fer-clerkx/speeduino-expo/adapter/readme.md

64 pin for NA Toyota MR2 SW20 (1992)

# [For sale here](https://www.tindie.com/products/russian/ecu-64p-connector-bare-pcb-honda-miata-nanb1/)

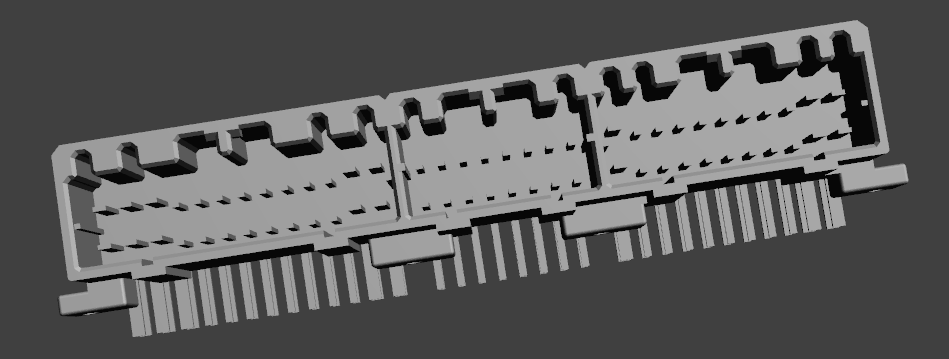
[picture p1: adapter/connector.png]
Connector


[Forum thread](https://rusefi.com/forum/viewtopic.php?f=4&t=507)
