fer-clerkx/speeduino-expo/adapter/Speeduino 1990 Rev2 3SGE ECU adapter 174518-7.kicad_pcb

## KiCad design adapter/Speeduino 1990 Rev2 3SGE ECU adapter 174518-7.kicad_pcb (2023-01-09)

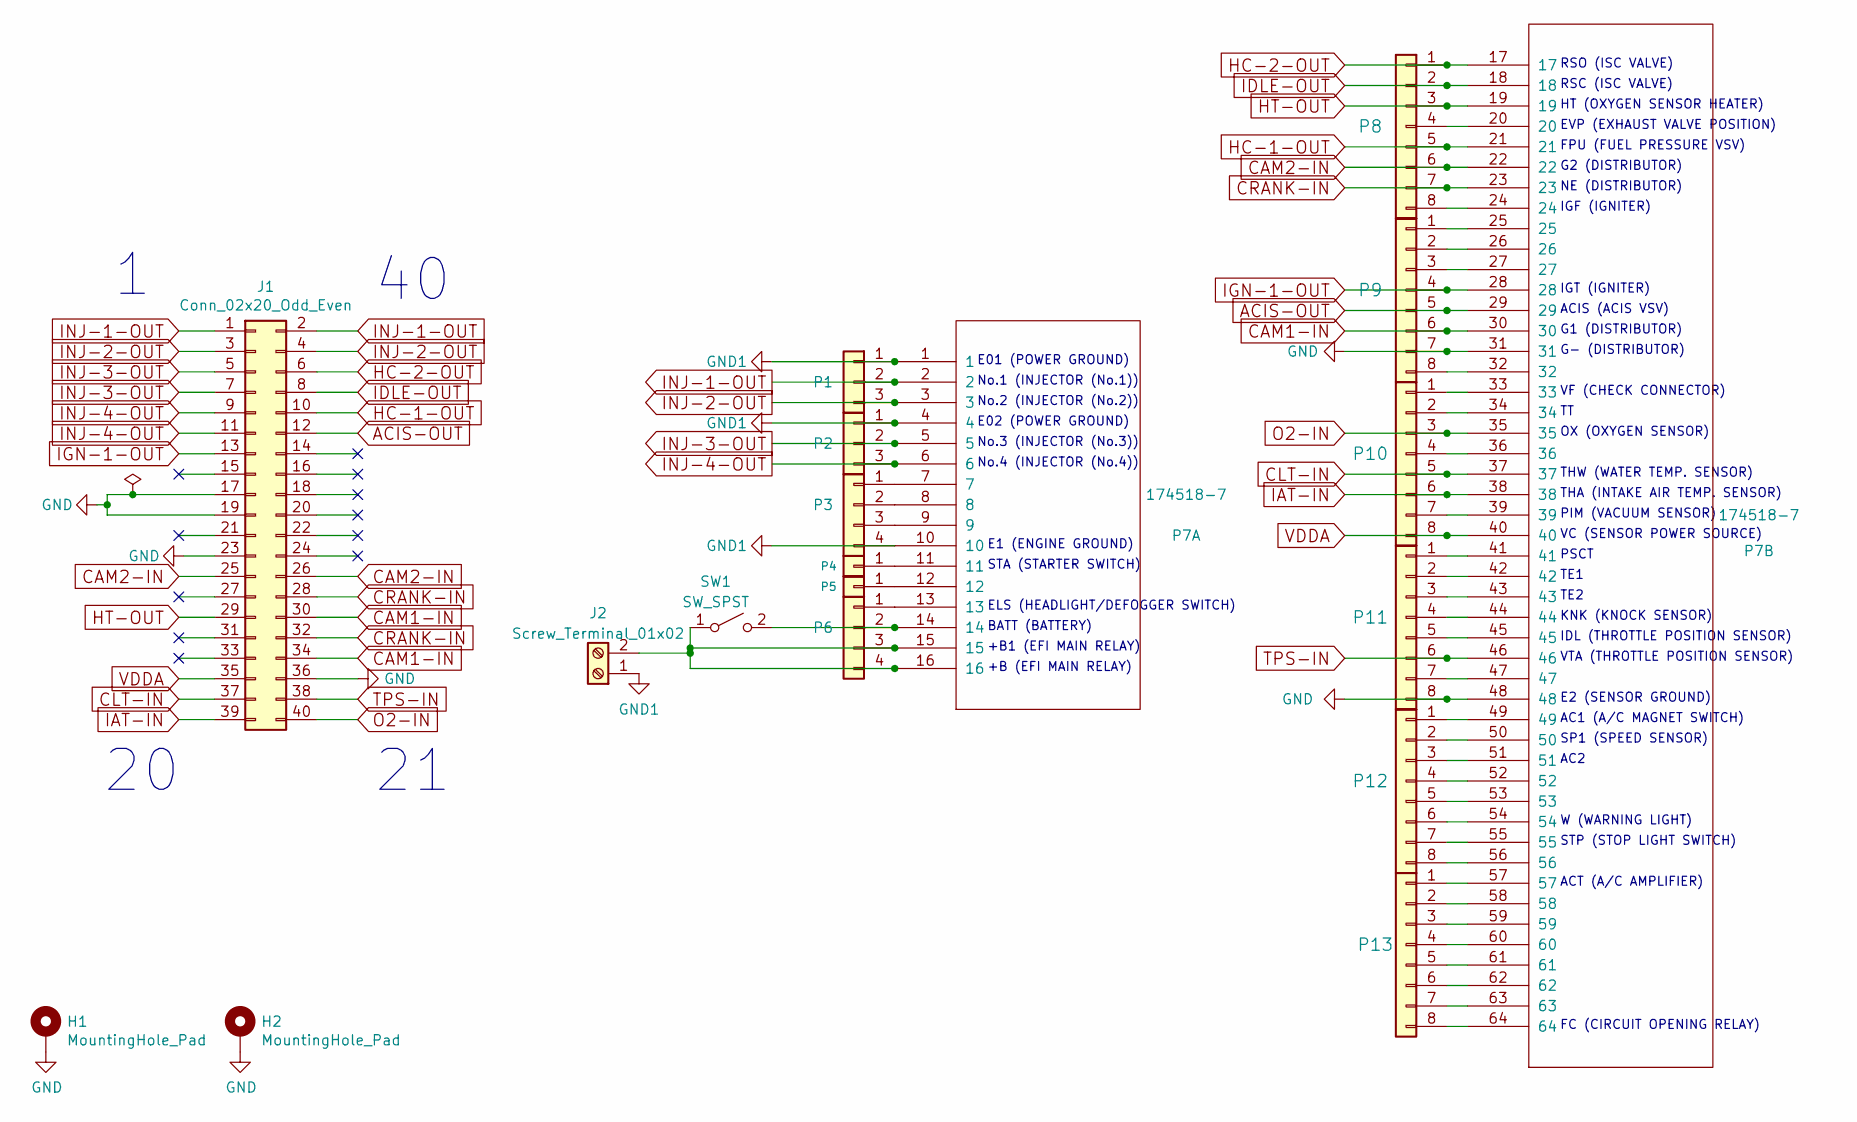
[picture p2: schematic Speeduino 1990 Rev2 3SGE ECU adapter 174518-7.kicad_sch, Speeduino 1990 R1 3S-GE ECU adapter by Jules van den Aker]

Parts:
H1, H2: MountingHole_Pad; MountingHole_3.2mm_M3_Pad_Via
J1: Conn_02x20_Odd_Even; IDC-Header_2x20_P2.54mm_Vertical
J2: Screw_Terminal_01x02; TerminalBlock_Phoenix_MKDS-1,5-2_1x02_P5.00mm_Horizontal
P1, P2: CONN_3; PinHeader_1x03_P2.54mm_Vertical
P3, P6: Conn_01x04_Male; PinHeader_2x02_P2.54mm_Vertical
P4, P5: CONN_1; PinHeader_1x01_P2.54mm_Vertical
P7: 174518-7
P8, P9, P10, P11, P12, P13: CONN_8; PinHeader_1x08_P2.54mm_Vertical
SW1: SW_SPST; SolderJumper-2_P1.3mm_Bridged_Pad1.0x1.5mm

Connections:
ACIS-OUT: J1.12, P7.29, P9.5
CAM1-IN: J1.30, J1.34, P7.30, P9.6
CAM2-IN: J1.25, J1.26, P7.22, P8.6
CLT-IN: J1.37, P7.37, P10.5
CRANK-IN: J1.28, J1.32, P7.23, P8.7
GND: H1.1, H2.1, J1.17, J1.19, J1.23, J1.36, P7.31, P7.48, P9.7, P11.8
GND1: J2.1, P1.1, P2.1, P3.4, P7.1, P7.4, P7.10
HC-1-OUT: J1.10, P7.21, P8.5
HC-2-OUT: J1.6, P7.17, P8.1
HT-OUT: J1.29, P7.19, P8.3
IAT-IN: J1.39, P7.38, P10.6
IDLE-OUT: J1.8, P7.18, P8.2
IGN-1-OUT: J1.13, P7.28, P9.4
INJ-1-OUT: J1.1, J1.2, P1.2, P7.2
INJ-2-OUT: J1.3, J1.4, P1.3, P7.3
INJ-3-OUT: J1.5, J1.7, P2.2, P7.5
INJ-4-OUT: J1.9, J1.11, P2.3, P7.6
unnamed: J2.2, P6.3, P6.4, P7.15, P7.16, SW1.1 (A)
unnamed: P3.1, P7.7
unnamed: P3.2, P7.8
unnamed: P3.3, P7.9
unnamed: P4.1, P7.11
unnamed: P5.1, P7.12
unnamed: P6.1, P7.13
unnamed: P6.2, P7.14, SW1.2 (B)
unnamed: P7.20, P8.4
unnamed: P7.24, P8.8
unnamed: P7.25, P9.1
unnamed: P7.26, P9.2
unnamed: P7.27, P9.3
unnamed: P7.32, P9.8
unnamed: P7.33, P10.1
unnamed: P7.34, P10.2
unnamed: P7.36, P10.4
unnamed: P7.39, P10.7
unnamed: P7.41, P11.1
unnamed: P7.42, P11.2
unnamed: P7.43, P11.3
unnamed: P7.44, P11.4
unnamed: P7.45, P11.5
unnamed: P7.47, P11.7
unnamed: P7.49, P12.1
unnamed: P7.50, P12.2
unnamed: P7.51, P12.3
unnamed: P7.52, P12.4
unnamed: P7.53, P12.5
unnamed: P7.54, P12.6
unnamed: P7.55, P12.7
unnamed: P7.56, P12.8
unnamed: P7.57, P13.1
unnamed: P7.58, P13.2
unnamed: P7.59, P13.3
unnamed: P7.60, P13.4
unnamed: P7.61, P13.5
unnamed: P7.62, P13.6
unnamed: P7.63, P13.7
unnamed: P7.64, P13.8
O2-IN: J1.40, P7.35, P10.3
TPS-IN: J1.38, P7.46, P11.6
VDDA: J1.35, P7.40, P10.8

Notes on the sheet:
IGT (IGNITER)
W (WARNING LIGHT)
E02 (POWER GROUND)
No.4 (INJECTOR (No.4))
G1 (DISTRIBUTOR)
No.2 (INJECTOR (No.2))
KNK (KNOCK SENSOR)
NE (DISTRIBUTOR)
STA (STARTER SWITCH)
FPU (FUEL PRESSURE VSV)
AC2
ACT (A/C AMPLIFIER)
+B1 (EFI MAIN RELAY)
RSO (ISC VALVE)
ELS (HEADLIGHT/DEFOGGER SWITCH)
G- (DISTRIBUTOR)
THA (INTAKE AIR TEMP. SENSOR)
No.3 (INJECTOR (No.3))
TE2
RSC (ISC VALVE)
VF (CHECK CONNECTOR)
HT (OXYGEN SENSOR HEATER)
TE1
THW (WATER TEMP. SENSOR)
+B (EFI MAIN RELAY)
E01 (POWER GROUND)
IGF (IGNITER)
OX (OXYGEN SENSOR)
G2 (DISTRIBUTOR)
No.1 (INJECTOR (No.1))
PSCT
FC (CIRCUIT OPENING RELAY)
VTA (THROTTLE POSITION SENSOR)
E2 (SENSOR GROUND)
VC (SENSOR POWER SOURCE)
SP1 (SPEED SENSOR)
ACIS (ACIS VSV)
AC1 (A/C MAGNET SWITCH)
IDL (THROTTLE POSITION SENSOR)
STP (STOP LIGHT SWITCH)
E1 (ENGINE GROUND)
PIM (VACUUM SENSOR)
EVP (EXHAUST VALVE POSITION)
BATT (BATTERY)

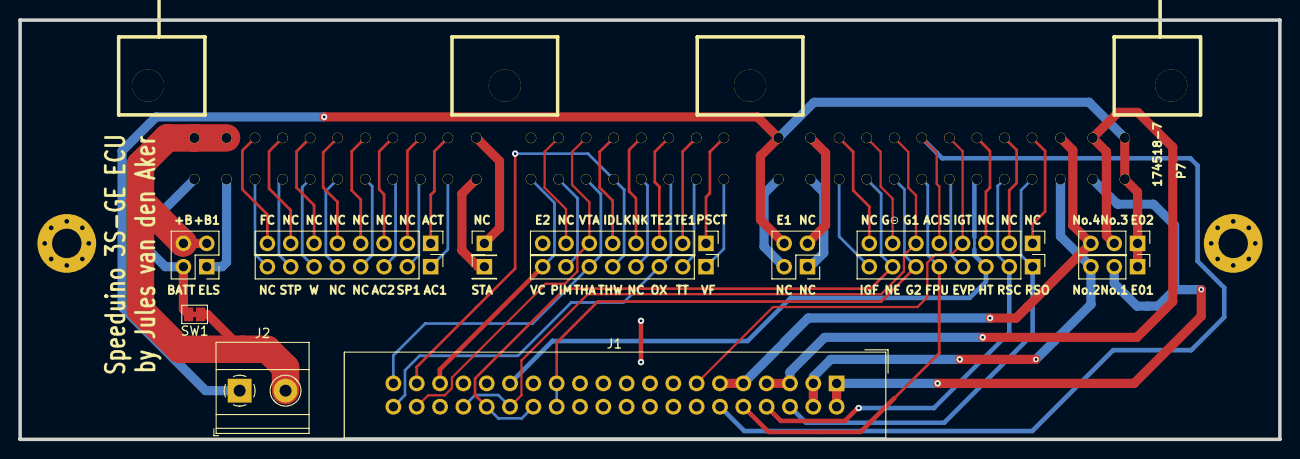
[picture p3: board Speeduino 1990 Rev2 3SGE ECU adapter 174518-7.kicad_pcb from above]

Board: 2 copper layers, 137.2 x 45.6 mm, 18 parts (0 on the bottom side), 60 nets.
