fer-clerkx/speeduino-expo/ECU_Board/perfectV2.1v0.kicad_pcb

## KiCad design ECU_Board/perfectV2.1v0.kicad_pcb (2023-01-07)

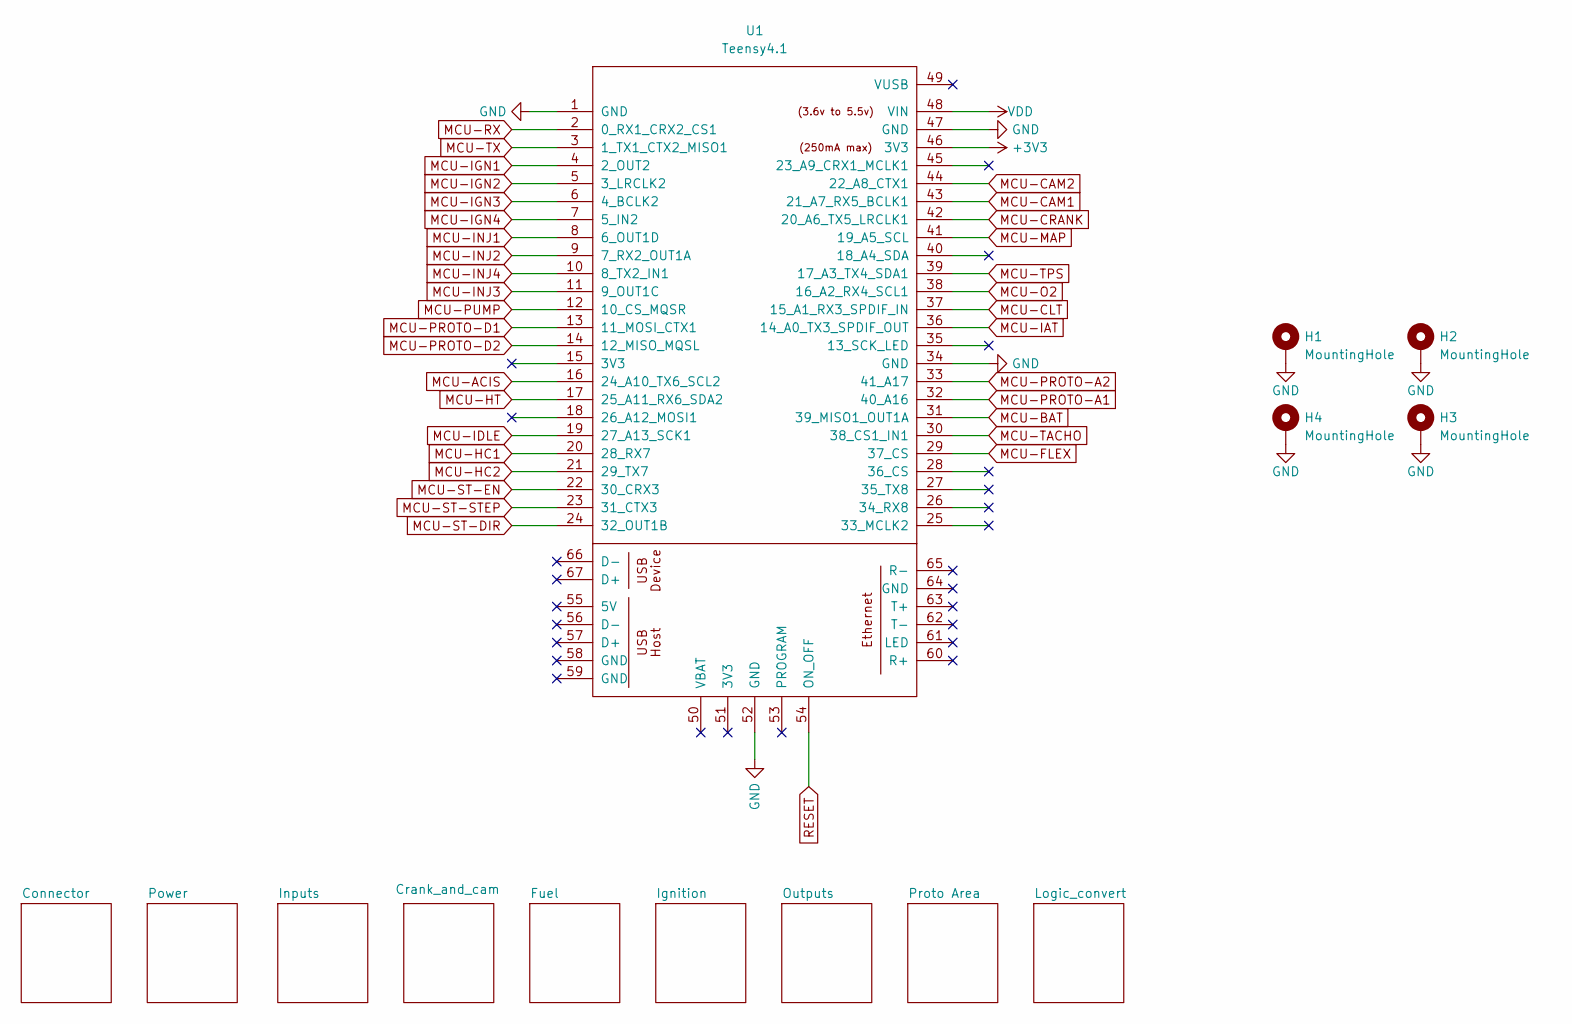
[picture p4: schematic perfectV2.1v0.kicad_sch, Speeduino board for Teensy 4.1]

Parts:
H1, H2, H3, H4: MountingHole; MountingHole_4.3mm_M4_Pad
U1: Teensy4.1; Teensy41

Connections:
+3V3: U1.46 (3V3); also elsewhere on the board
GND: H1.1, H2.1, H3.1, H4.1, U1.1 (GND), U1.34 (GND), U1.47 (GND), U1.52 (GND); also elsewhere on the board
MCU-ACIS: U1.16 (24_A10_TX6_SCL2); also elsewhere on the board
MCU-BAT: U1.31 (39_MISO1_OUT1A); also elsewhere on the board
MCU-CAM1: U1.43 (21_A7_RX5_BCLK1); also elsewhere on the board
MCU-CAM2: U1.44 (22_A8_CTX1); also elsewhere on the board
MCU-CLT: U1.37 (15_A1_RX3_SPDIF_IN); also elsewhere on the board
MCU-CRANK: U1.42 (20_A6_TX5_LRCLK1); also elsewhere on the board
MCU-FLEX: U1.29 (37_CS); also elsewhere on the board
MCU-HC1: U1.20 (28_RX7); also elsewhere on the board
MCU-HC2: U1.21 (29_TX7); also elsewhere on the board
MCU-HT: U1.17 (25_A11_RX6_SDA2); also elsewhere on the board
MCU-IAT: U1.36 (14_A0_TX3_SPDIF_OUT); also elsewhere on the board
MCU-IDLE: U1.19 (27_A13_SCK1); also elsewhere on the board
MCU-IGN1: U1.4 (2_OUT2); also elsewhere on the board
MCU-IGN2: U1.5 (3_LRCLK2); also elsewhere on the board
MCU-IGN3: U1.6 (4_BCLK2); also elsewhere on the board
MCU-IGN4: U1.7 (5_IN2); also elsewhere on the board
MCU-INJ1: U1.8 (6_OUT1D); also elsewhere on the board
MCU-INJ2: U1.9 (7_RX2_OUT1A); also elsewhere on the board
MCU-INJ3: U1.11 (9_OUT1C); also elsewhere on the board
MCU-INJ4: U1.10 (8_TX2_IN1); also elsewhere on the board
MCU-MAP: U1.41 (19_A5_SCL); also elsewhere on the board
MCU-O2: U1.38 (16_A2_RX4_SCL1); also elsewhere on the board
MCU-PROTO-A1: U1.32 (40_A16); also elsewhere on the board
MCU-PROTO-A2: U1.33 (41_A17); also elsewhere on the board
MCU-PROTO-D1: U1.13 (11_MOSI_CTX1); also elsewhere on the board
MCU-PROTO-D2: U1.14 (12_MISO_MQSL); also elsewhere on the board
MCU-PUMP: U1.12 (10_CS_MQSR); also elsewhere on the board
MCU-RX: U1.2 (0_RX1_CRX2_CS1); also elsewhere on the board
MCU-ST-DIR: U1.24 (32_OUT1B); also elsewhere on the board
MCU-ST-EN: U1.22 (30_CRX3); also elsewhere on the board
MCU-ST-STEP: U1.23 (31_CTX3); also elsewhere on the board
MCU-TACHO: U1.30 (38_CS1_IN1); also elsewhere on the board
MCU-TPS: U1.39 (17_A3_TX4_SDA1); also elsewhere on the board
MCU-TX: U1.3 (1_TX1_CTX2_MISO1); also elsewhere on the board
RESET: U1.54 (ON_OFF); also elsewhere on the board
VDD: U1.48 (VIN); also elsewhere on the board

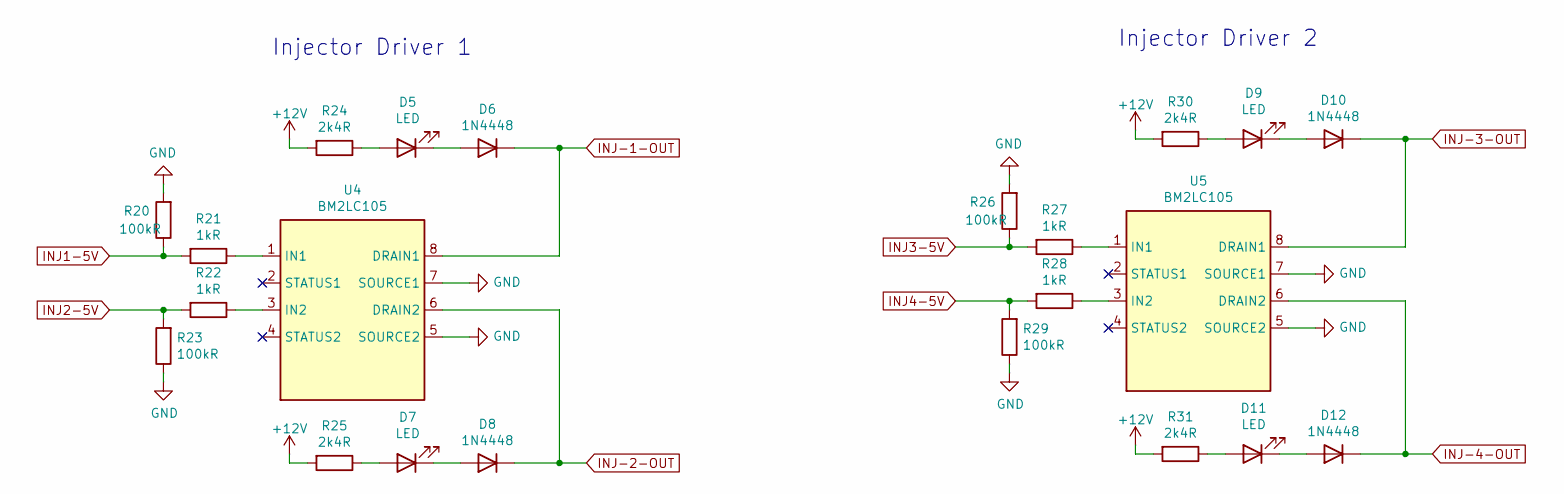
[picture p5: schematic Fuel.kicad_sch, Speeduino board for Teensy 4.1]

Parts:
D5, D7, D9, D11: LED; LED_0805_2012Metric; Manufacturer_Part_Number MP008293; Digikey Part Number 3796325
D6, D8, D10, D12: 1N4448; D_SOD-123; Manufacturer_Part_Number 1N4448W-7-F; Digikey Part Number 1843738
R20, R23, R26, R29: 100kR; R_0402_1005Metric; Manufacturer_Part_Number WF04P1003FTL; Digikey Part Number 2502803
R21, R22, R27, R28: 1kR; R_0402_1005Metric; Manufacturer_Part_Number WF04P1001FTL; Digikey Part Number 2502798
R24, R25, R30, R31: 2k4R; R_0805_2012Metric; Manufacturer_Part_Number MCWR08X2401FTL; Digikey Part Number 2447625
U4, U5: BM2LC105; SOP-8_3.9x4.9mm_P1.27mm; Manufacturer_Part_Number BM2LC105FJ-CE2; Digikey Part Number BM2LC105FJ-CE2CT-ND

Connections:
+12V: R24.2, R25.2, R30.2, R31.2; also elsewhere on the board
GND: R20.2, R23.1, R26.2, R29.1, U4.5 (SOURCE2), U4.7 (SOURCE1), U5.5 (SOURCE2), U5.7 (SOURCE1); also elsewhere on the board
INJ1-5V: R20.1, R21.2; also elsewhere on the board
INJ2-5V: R22.2, R23.2; also elsewhere on the board
INJ3-5V: R26.1, R27.2; also elsewhere on the board
INJ4-5V: R28.2, R29.2; also elsewhere on the board
INJ-1-OUT: D6.1 (K), U4.8 (DRAIN1); also elsewhere on the board
INJ-2-OUT: D8.1 (K), U4.6 (DRAIN2); also elsewhere on the board
INJ-3-OUT: D10.1 (K), U5.8 (DRAIN1); also elsewhere on the board
INJ-4-OUT: D12.1 (K), U5.6 (DRAIN2); also elsewhere on the board
unnamed: D5.1 (K), D6.2 (A)
unnamed: D5.2 (A), R24.1
unnamed: D7.1 (K), D8.2 (A)
unnamed: D7.2 (A), R25.1
unnamed: D9.2 (A), R30.1
unnamed: D9.1 (K), D10.2 (A)
unnamed: D11.1 (K), D12.2 (A)
unnamed: D11.2 (A), R31.1
unnamed: R21.1, U4.1 (IN1)
unnamed: R22.1, U4.3 (IN2)
unnamed: R27.1, U5.1 (IN1)
unnamed: R28.1, U5.3 (IN2)

Notes on the sheet:
Injector Driver 2
Injector Driver 1

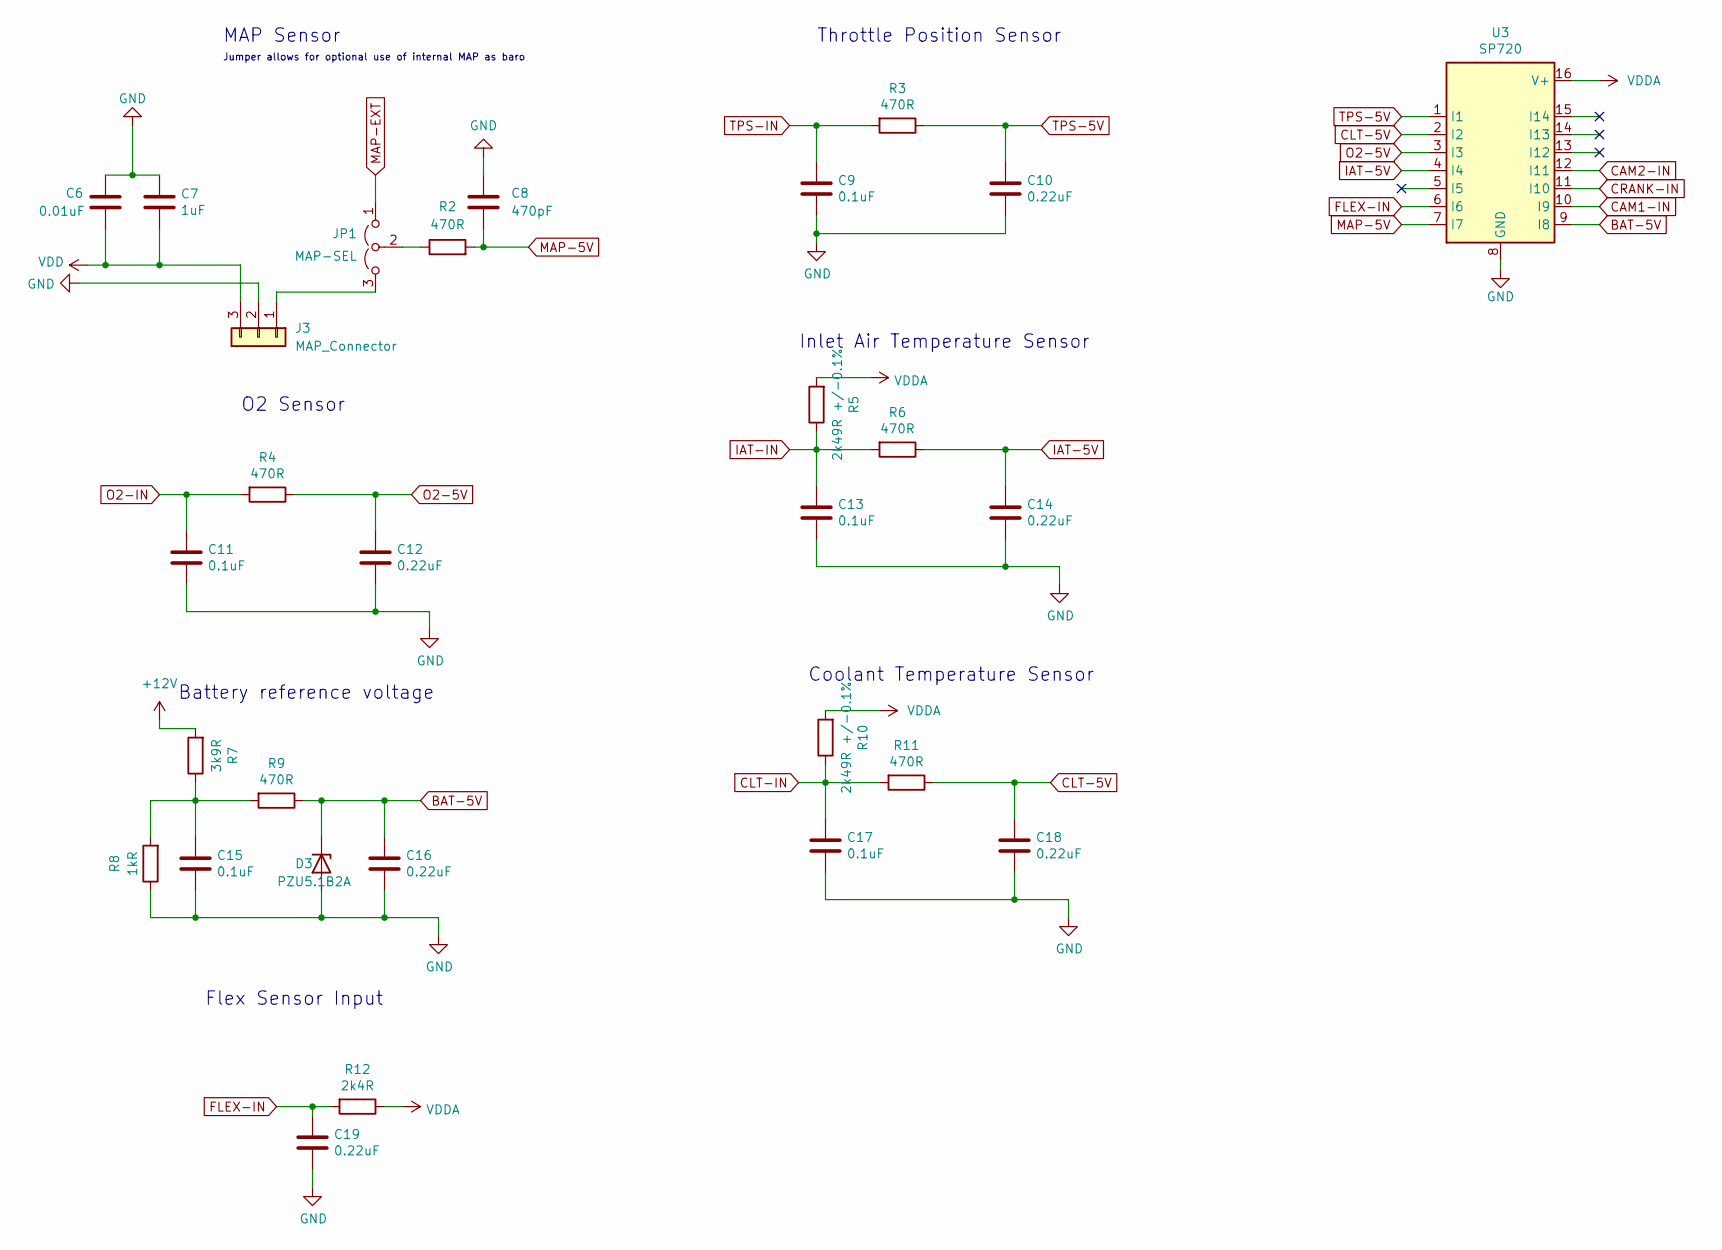
[picture p6: schematic inputs.kicad_sch, Speeduino board for Teensy 4.1]

Parts:
C6: 0.01uF; C_0805_2012Metric; Manufacturer_Part_Number CC0805KRX7R9BB103; Digikey Part Number 3019937
C7: 1uF; C_0805_2012Metric; Manufacturer_Part_Number CC0805KKX7R7BB105; Digikey Part Number 3369302
C8: 470pF; C_0805_2012Metric; Manufacturer_Part_Number MC0805B471K500CT; Digikey Part Number 1759216
C9, C11, C13, C15, C17: 0.1uF; C_0805_2012Metric; Manufacturer_Part_Number VJ0805Y104KXAPW1BC; Digikey Part Number 3296136
C10, C12, C14, C16, C18, C19: 0.22uF; C_0805_2012Metric; Manufacturer_Part_Number 0805B224M160CP; Digikey Part Number 3881054
D3: PZU5.1B2A; D_SOD-323; Manufacturer_Part_Number PZU5.1B2A-QX; Digikey Part Number 4126444
J3: MAP_Connector; PinSocket_1x03_P2.54mm_Vertical
JP1: MAP-SEL; PinHeader_1x03_P2.54mm_Vertical
R2, R3, R4, R6, R9, R11: 470R; R_0805_2012Metric; Manufacturer_Part_Number WF08P4700FTL; Digikey Part Number 2670094
R5, R10: 2k49R +/-0.1%; R_0805_2012Metric; Manufacturer_Part_Number RT0805BRD072K49L; Digikey Part Number 4014068
R7: 3k9R; R_0805_2012Metric; Manufacturer_Part_Number MCWR08X3901FTL; Digikey Part Number 2447654
R8: 1kR; R_0402_1005Metric; Manufacturer_Part_Number WF04P1001FTL; Digikey Part Number 2502798
R12: 2k4R; R_0805_2012Metric; Manufacturer_Part_Number MCWR08X2401FTL; Digikey Part Number 2447625
U3: SP720; SOIC-16_3.9x9.9mm_P1.27mm; Manufacturer_Part_Number SP720ABG; Digikey Part Number 1869378

Connections:
+12V: R7.2; also elsewhere on the board
BAT-5V: C16.1, D3.1 (K), R9.1, U3.9 (I8); also elsewhere on the board
CAM1-IN: U3.10 (I9); also elsewhere on the board
CAM2-IN: U3.12 (I11); also elsewhere on the board
CLT-5V: C18.1, R11.1, U3.2 (I2); also elsewhere on the board
CLT-IN: C17.1, R10.1, R11.2; also elsewhere on the board
CRANK-IN: U3.11 (I10); also elsewhere on the board
FLEX-IN: C19.1, R12.2, U3.6 (I6); also elsewhere on the board
GND: C6.1, C7.1, C8.1, C9.2, C10.2, C11.2, C12.2, C13.2, C14.2, C15.2, C16.2, C17.2, C18.2, C19.2, D3.2 (A), J3.2, R8.1, U3.8 (GND); also elsewhere on the board
IAT-5V: C14.1, R6.1, U3.4 (I4); also elsewhere on the board
IAT-IN: C13.1, R5.1, R6.2; also elsewhere on the board
MAP-5V: C8.2, R2.2, U3.7 (I7); also elsewhere on the board
MAP-EXT: JP1.1 (A); also elsewhere on the board
unnamed: C15.1, R7.1, R8.2, R9.2
unnamed: J3.1, JP1.3 (B)
unnamed: JP1.2 (C), R2.1
O2-5V: C12.1, R4.1, U3.3 (I3); also elsewhere on the board
O2-IN: C11.1, R4.2; also elsewhere on the board
TPS-5V: C10.1, R3.1, U3.1 (I1); also elsewhere on the board
TPS-IN: C9.1, R3.2; also elsewhere on the board
VDD: C6.2, C7.2, J3.3; also elsewhere on the board
VDDA: R5.2, R10.2, R12.1, U3.16 (V+); also elsewhere on the board

Notes on the sheet:
Coolant Temperature Sensor
Battery reference voltage
Inlet Air Temperature Sensor
Flex Sensor Input
O2 Sensor
Jumper allows for optional use of internal MAP as baro
Throttle Position Sensor
MAP Sensor

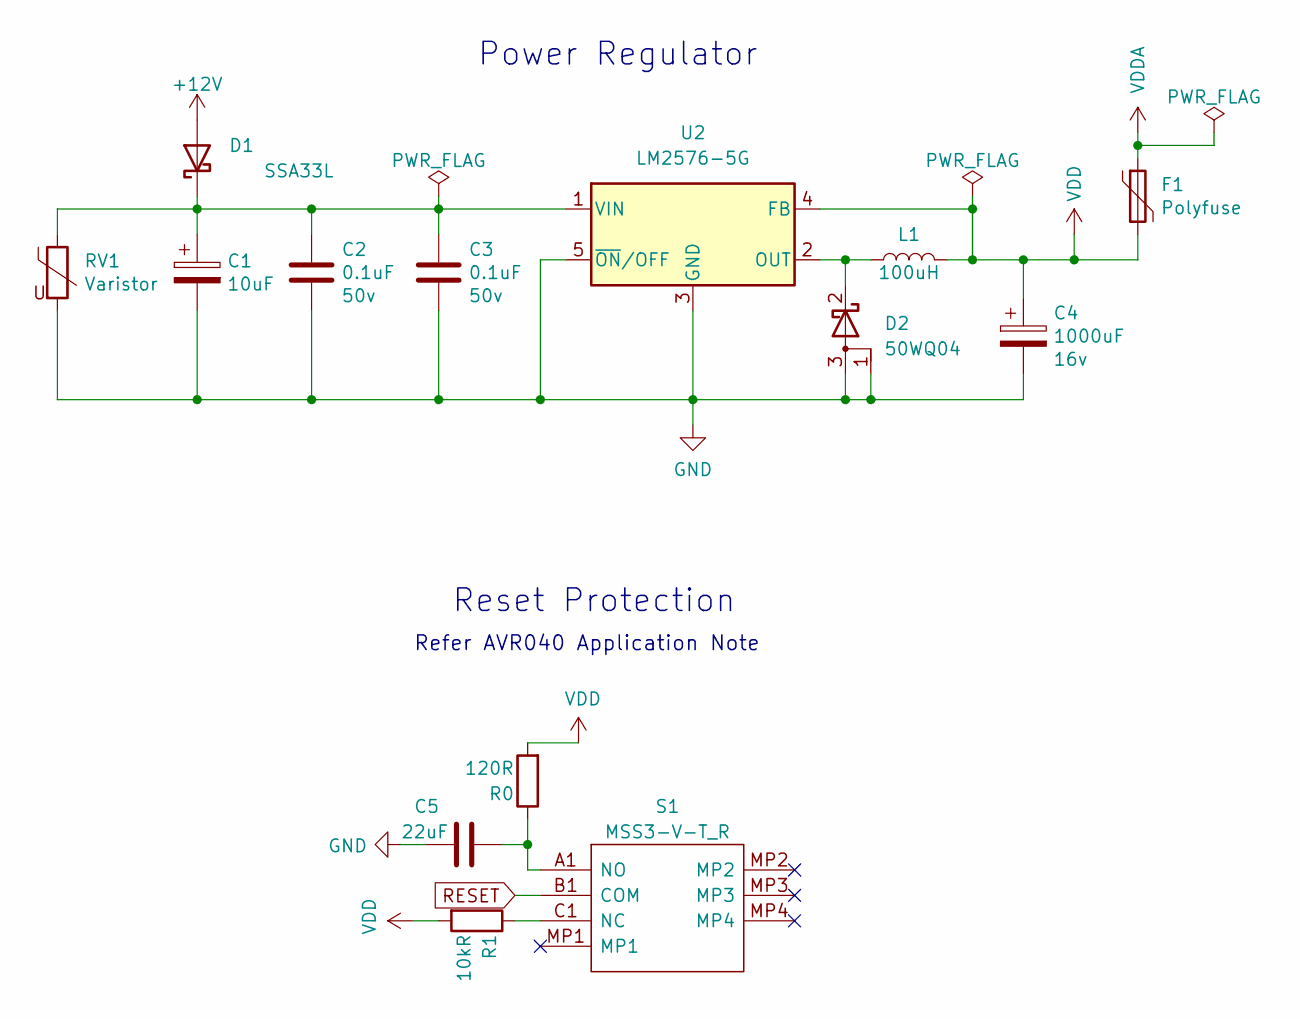
[picture p7: schematic power.kicad_sch, Speeduino board for Teensy 4.1]

Parts:
C1: 10uF; CP_EIA-7343-31_Kemet-D; Voltage 35v; Manufacturer_Part_Number TAJD106K050RNJ; Digikey Part Number 1432387
C2, C3: 0.1uF; C_0805_2012Metric; Voltage 50v; Manufacturer_Part_Number VJ0805Y104KXAPW1BC; Digikey Part Number 3296136
C4: 1000uF; CP_Elec_16x17.5; Voltage 16v; Manufacturer_Part_Number MCVZH050M102JB7L; Digikey Part Number 2630479
C5: 22uF; C_0805_2012Metric; Manufacturer_Part_Number GRM21BR61A226ME51K; Digikey Part Number 3581408
D1: SSA33L; D_SMA; Manufacturer_Part_Number SSA33L-E3/61T; Digikey Part Number 1336552
D2: 50WQ04; TO-252-3_TabPin4; Manufacturer_Part_Number VS-50WQ04FNTR-M3; Digikey Part Number 2646457
F1: Polyfuse; Fuse_1812_4532Metric; Manufacturer_Part_Number SMD1812B050TF/30; Digikey Part Number 3052512
L1: 100uH; L_12x12mm_H8mm; Manufacturer_Part_Number MSS1210-104KED; Digikey Part Number 2288307
R0: 120R; R_0603_1608Metric; Manufacturer_Part_Number WF06P1200FTL; Digikey Part Number 2670000
R1: 10kR; R_0805_2012Metric; Manufacturer_Part_Number CRG0805F10K/10; Digikey Part Number 3399587
RV1: Varistor; C_2220_5650Metric; Manufacturer_Part_Number VC2220K122R014; Digikey Part Number 2989479
S1: MSS3-V-T_R; MSS3VTR; Manufacturer_Part_Number MSS3-V-T/R; Digikey Part Number 2113262
U2: LM2576-5G; TO-263-5_TabPin6; Manufacturer_Part_Number LM2576D2TR4-5G; Digikey Part Number 2534166

Connections:
+12V: D1.2 (A); also elsewhere on the board
GND: C1.2, C2.2, C3.2, C4.2, C5.2, D2.1 (A), D2.3 (A), RV1.2, U2.3 (GND), U2.5 (~ON/OFF); also elsewhere on the board
unnamed: C1.1, C2.1, C3.1, D1.1 (K), RV1.1, U2.1 (VIN)
unnamed: C5.1, R0.1, S1.A1 (NO)
unnamed: D2.2 (K), L1.1, U2.2 (OUT)
unnamed: R1.1, S1.C1 (NC)
RESET: S1.B1 (COM); also elsewhere on the board
VDD: C4.1, F1.2, L1.2, R0.2, R1.2, U2.4 (FB); also elsewhere on the board
VDDA: F1.1; also elsewhere on the board

Notes on the sheet:
Power Regulator
Reset Protection
Refer AVR040 Application Note

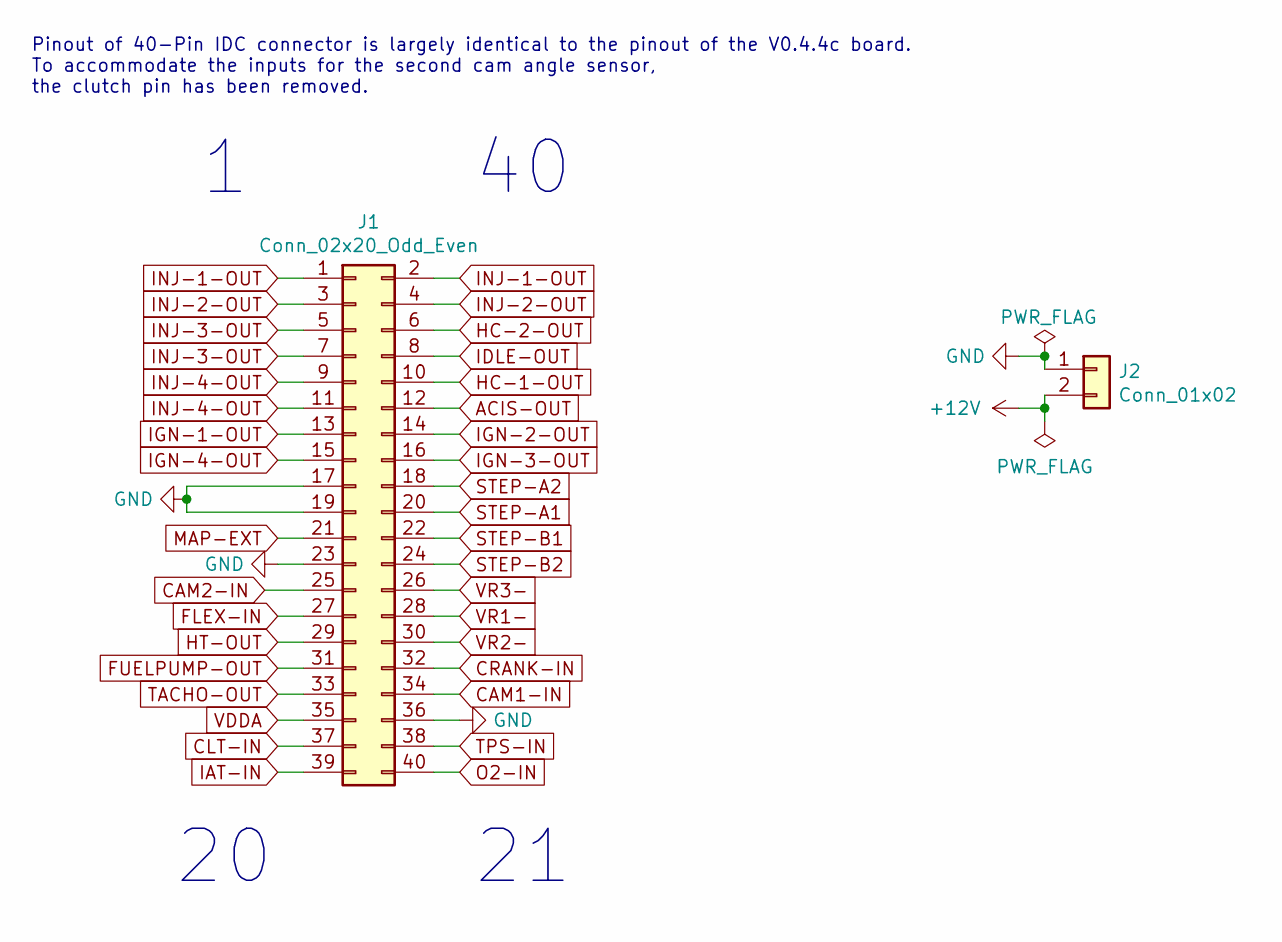
[picture p8: schematic connector.kicad_sch, Speeduino board for Teensy 4.1]

Parts:
J1: Conn_02x20_Odd_Even; IDC-Header_2x20_P2.54mm_Vertical
J2: Conn_01x02; TerminalBlock_Phoenix_MKDS-1,5-2-5.08_1x02_P5.08mm_Horizont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; Manufacturer_Part_Number PM5.08/2/90 BLK

Connections:
+12V: J2.2; also elsewhere on the board
ACIS-OUT: J1.12; also elsewhere on the board
CAM1-IN: J1.34; also elsewhere on the board
CAM2-IN: J1.25; also elsewhere on the board
CLT-IN: J1.37; also elsewhere on the board
CRANK-IN: J1.32; also elsewhere on the board
FLEX-IN: J1.27; also elsewhere on the board
FUELPUMP-OUT: J1.31; also elsewhere on the board
GND: J1.17, J1.19, J1.23, J1.36, J2.1; also elsewhere on the board
HC-1-OUT: J1.10; also elsewhere on the board
HC-2-OUT: J1.6; also elsewhere on the board
HT-OUT: J1.29; also elsewhere on the board
IAT-IN: J1.39; also elsewhere on the board
IDLE-OUT: J1.8; also elsewhere on the board
IGN-1-OUT: J1.13; also elsewhere on the board
IGN-2-OUT: J1.14; also elsewhere on the board
IGN-3-OUT: J1.16; also elsewhere on the board
IGN-4-OUT: J1.15; also elsewhere on the board
INJ-1-OUT: J1.1, J1.2; also elsewhere on the board
INJ-2-OUT: J1.3, J1.4; also elsewhere on the board
INJ-3-OUT: J1.5, J1.7; also elsewhere on the board
INJ-4-OUT: J1.9, J1.11; also elsewhere on the board
MAP-EXT: J1.21; also elsewhere on the board
O2-IN: J1.40; also elsewhere on the board
STEP-A1: J1.20; also elsewhere on the board
STEP-A2: J1.18; also elsewhere on the board
STEP-B1: J1.22; also elsewhere on the board
STEP-B2: J1.24; also elsewhere on the board
TACHO-OUT: J1.33; also elsewhere on the board
TPS-IN: J1.38; also elsewhere on the board
VDDA: J1.35; also elsewhere on the board
VR1-: J1.28; also elsewhere on the board
VR2-: J1.30; also elsewhere on the board
VR3-: J1.26; also elsewhere on the board

Notes on the sheet:
Pinout of 40-Pin IDC connector is largely identical to the pinout of the V0.4.4c board. To accommodate the inputs for the second cam angle sensor, the clutch pin has been removed.

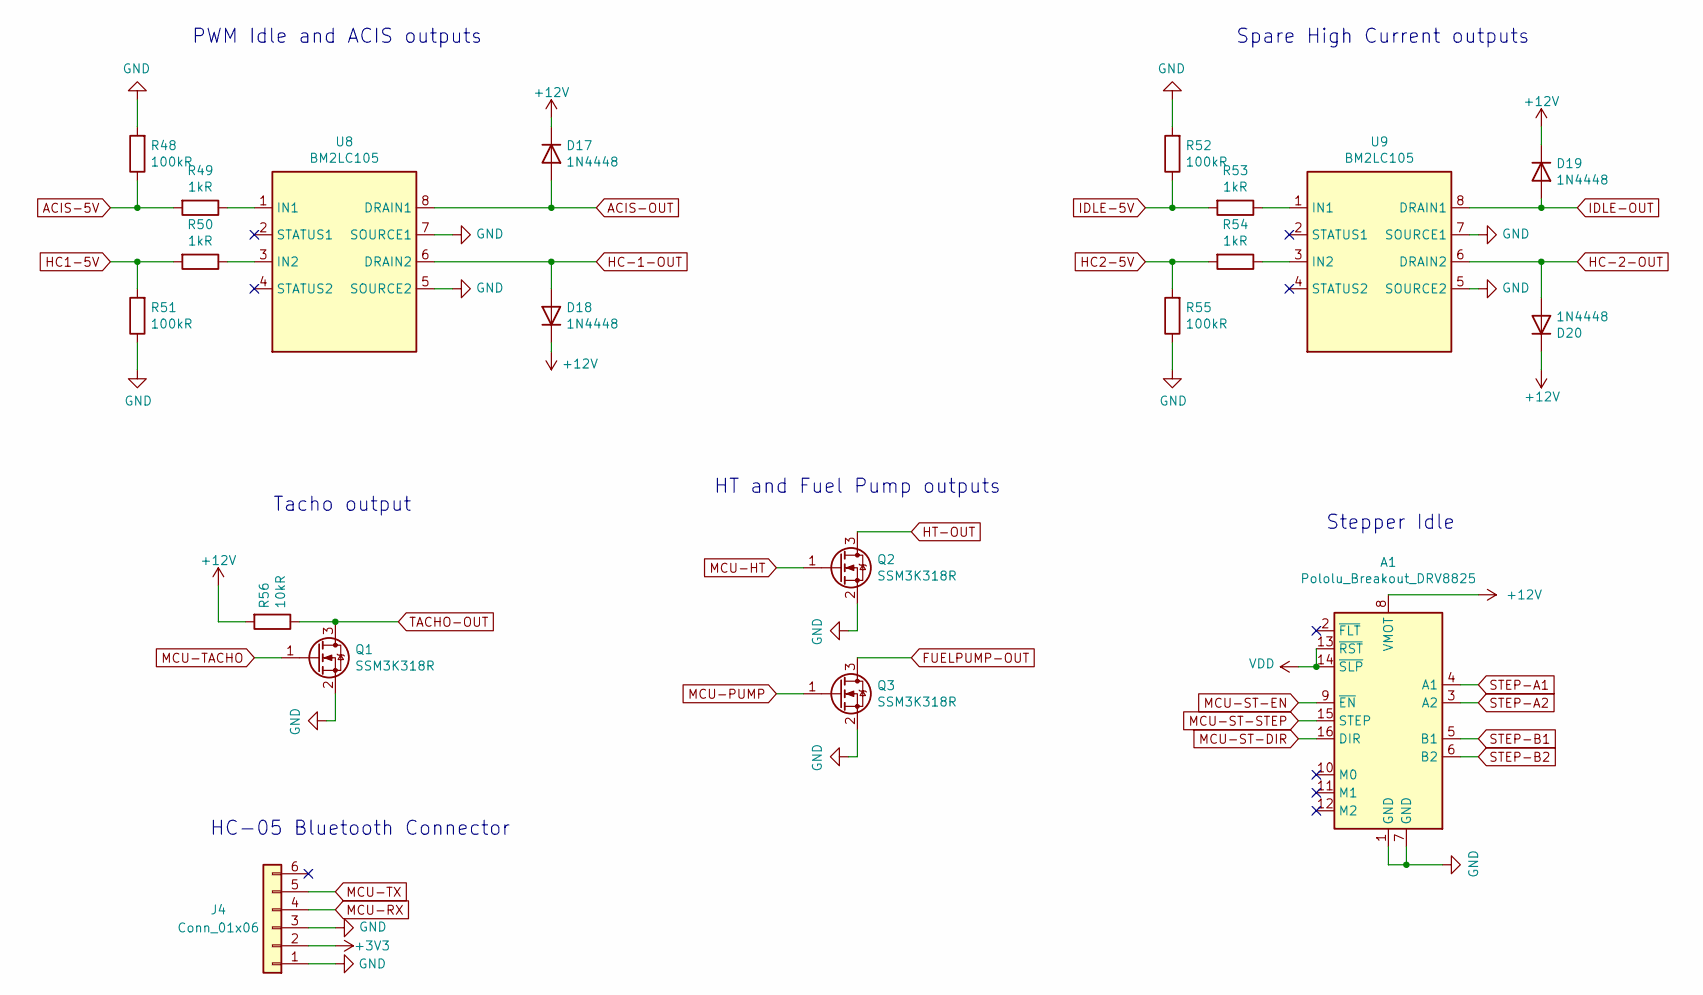
[picture p9: schematic outputs.kicad_sch, Speeduino board for Teensy 4.1]

Parts:
A1: Pololu_Breakout_DRV8825; Pololu_Breakout-16_15.2x20.3mm
D17, D18, D19, D20: 1N4448; D_SOD-123; Manufacturer_Part_Number 1N4448W-7-F; Digikey Part Number 1843738
J4: Conn_01x06; PinHeader_1x06_P2.54mm_Vertical
Q1, Q2, Q3: SSM3K318R; SOT-23; Manufacturer_Part_Number SSM3K318R; Digikey Part Number 3870097
R48, R51, R52, R55: 100kR; R_0402_1005Metric; Manufacturer_Part_Number WF04P1003FTL; Digikey Part Number 2502803
R49, R50, R53, R54: 1kR; R_0402_1005Metric; Manufacturer_Part_Number WF04P1001FTL; Digikey Part Number 2502798
R56: 10kR; R_0805_2012Metric; Manufacturer_Part_Number CRG0805F10K/10; Digikey Part Number 3399587
U8, U9: BM2LC105; SOP-8_3.9x4.9mm_P1.27mm; Manufacturer_Part_Number BM2LC105FJ-CE2; Digikey Part Number BM2LC105FJ-CE2CT-ND

Connections:
+3V3: J4.2; also elsewhere on the board
+12V: A1.8 (VMOT), D17.1 (K), D18.1 (K), D19.1 (K), D20.1 (K), R56.2; also elsewhere on the board
ACIS-5V: R48.1, R49.2; also elsewhere on the board
ACIS-OUT: D17.2 (A), U8.8 (DRAIN1); also elsewhere on the board
FUELPUMP-OUT: Q3.3 (D); also elsewhere on the board
GND: A1.1 (GND), A1.7 (GND), J4.1, J4.3, Q1.2 (S), Q2.2 (S), Q3.2 (S), R48.2, R51.1, R52.2, R55.1, U8.5 (SOURCE2), U8.7 (SOURCE1), U9.5 (SOURCE2), U9.7 (SOURCE1); also elsewhere on the board
HC1-5V: R50.2, R51.2; also elsewhere on the board
HC2-5V: R54.2, R55.2; also elsewhere on the board
HC-1-OUT: D18.2 (A), U8.6 (DRAIN2); also elsewhere on the board
HC-2-OUT: D20.2 (A), U9.6 (DRAIN2); also elsewhere on the board
HT-OUT: Q2.3 (D); also elsewhere on the board
IDLE-5V: R52.1, R53.2; also elsewhere on the board
IDLE-OUT: D19.2 (A), U9.8 (DRAIN1); also elsewhere on the board
MCU-HT: Q2.1 (G); also elsewhere on the board
MCU-PUMP: Q3.1 (G); also elsewhere on the board
MCU-RX: J4.4; also elsewhere on the board
MCU-ST-DIR: A1.16 (DIR); also elsewhere on the board
MCU-ST-EN: A1.9 (~EN); also elsewhere on the board
MCU-ST-STEP: A1.15 (STEP); also elsewhere on the board
MCU-TACHO: Q1.1 (G); also elsewhere on the board
MCU-TX: J4.5; also elsewhere on the board
unnamed: R49.1, U8.1 (IN1)
unnamed: R50.1, U8.3 (IN2)
unnamed: R53.1, U9.1 (IN1)
unnamed: R54.1, U9.3 (IN2)
STEP-A1: A1.4 (A1); also elsewhere on the board
STEP-A2: A1.3 (A2); also elsewhere on the board
STEP-B1: A1.5 (B1); also elsewhere on the board
STEP-B2: A1.6 (B2); also elsewhere on the board
TACHO-OUT: Q1.3 (D), R56.1; also elsewhere on the board
VDD: A1.13 (~RST), A1.14 (~SLP); also elsewhere on the board

Notes on the sheet:
HT and Fuel Pump outputs
Stepper Idle
PWM Idle and ACIS outputs
HC-05 Bluetooth Connector
Tacho output
Spare High Current outputs

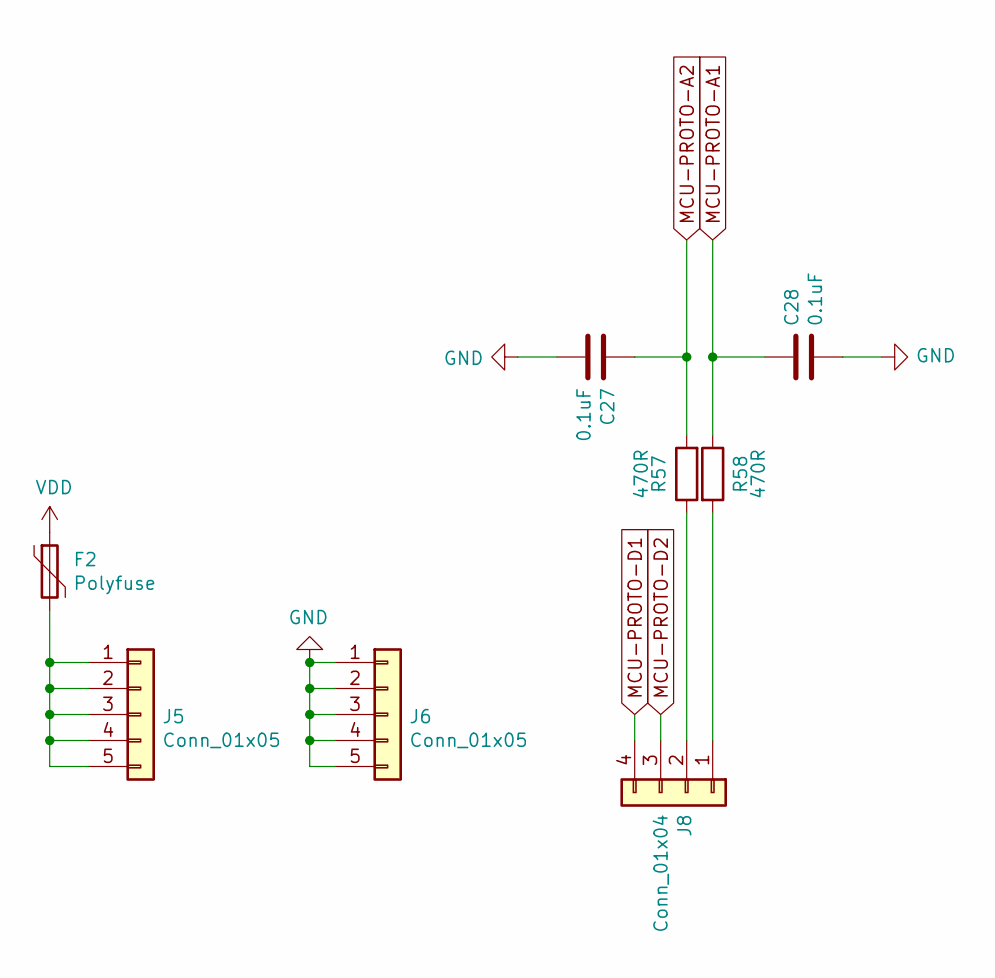
[picture p10: schematic proto.kicad_sch, Speeduino board for Teensy 4.1]

Parts:
C27, C28: 0.1uF; C_0805_2012Metric; Manufacturer_Part_Number VJ0805Y104KXAPW1BC; Digikey Part Number 3296136
F2: Polyfuse; Fuse_1812_4532Metric; Manufacturer_Part_Number SMD1812B050TF/30; Digikey Part Number 3052512
J5, J6: Conn_01x05; PinHeader_1x05_P2.54mm_Vertical
J8: Conn_01x04; PinHeader_1x04_P2.54mm_Vertical
R57, R58: 470R; R_0805_2012Metric; Manufacturer_Part_Number WF08P4700FTL; Digikey Part Number 2670094

Connections:
GND: C27.2, C28.2, J6.1, J6.2, J6.3, J6.4, J6.5; also elsewhere on the board
MCU-PROTO-A1: C28.1, R57.1; also elsewhere on the board
MCU-PROTO-A2: C27.1, R58.2; also elsewhere on the board
MCU-PROTO-D1: J8.4; also elsewhere on the board
MCU-PROTO-D2: J8.3; also elsewhere on the board
unnamed: F2.2, J5.1, J5.2, J5.3, J5.4, J5.5
unnamed: J8.1, R57.2
unnamed: J8.2, R58.1
VDD: F2.1; also elsewhere on the board
