fer-clerkx/speeduino-expo/ECU_Board/perfectV2.1v0.kicad_pcb

## KiCad design ECU_Board/perfectV2.1v0.kicad_pcb (continued)

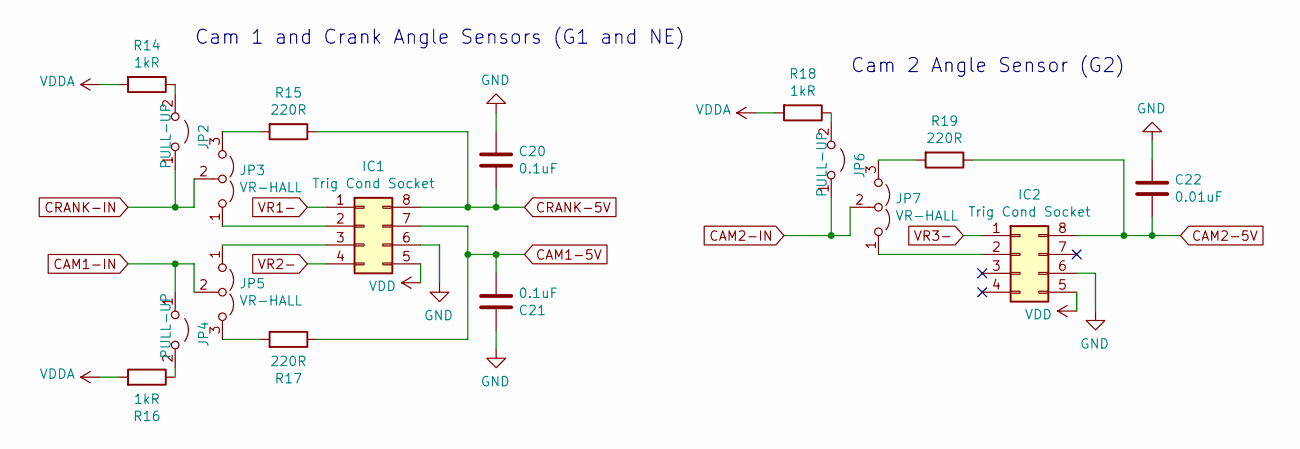
[picture p11: schematic Crank_and_cam.kicad_sch, Speeduino board for Teensy 4.1]

Parts:
C20, C21: 0.1uF; C_0805_2012Metric; Manufacturer_Part_Number VJ0805Y104KXAPW1BC; Digikey Part Number 3296136
C22: 0.01uF; C_0805_2012Metric; Manufacturer_Part_Number CC0805KRX7R9BB103; Digikey Part Number 3019937
IC1, IC2: Trig Cond Socket; DIP-8_W7.62mm_Socket; Manufacturer_Part_Number 2227MC-08-03-18-F1; Digikey Part Number 1103844
JP2, JP4, JP6: PULL-UP; PinHeader_1x02_P2.54mm_Vertical
JP3, JP5, JP7: VR-HALL; PinHeader_1x03_P2.54mm_Vertical
R14, R16, R18: 1kR; R_0402_1005Metric; Manufacturer_Part_Number WF04P1001FTL; Digikey Part Number 2502798
R15, R17, R19: 220R; R_0603_1608Metric; Manufacturer_Part_Number MR06X2200FTLV; Digikey Part Number 3994459

Connections:
CAM1-5V: C21.2, IC1.7, R17.1; also elsewhere on the board
CAM1-IN: JP4.1 (A), JP5.2 (C); also elsewhere on the board
CAM2-5V: C22.2, IC2.8, R19.1; also elsewhere on the board
CAM2-IN: JP6.1 (A), JP7.2 (C); also elsewhere on the board
CRANK-5V: C20.2, IC1.8, R15.1; also elsewhere on the board
CRANK-IN: JP2.1 (A), JP3.2 (C); also elsewhere on the board
GND: C20.1, C21.1, C22.1, IC1.6, IC2.6; also elsewhere on the board
unnamed: IC1.2, JP3.1 (A)
unnamed: IC1.3, JP5.1 (A)
unnamed: IC2.2, JP7.1 (A)
unnamed: JP2.2 (B), R14.1
unnamed: JP3.3 (B), R15.2
unnamed: JP4.2 (B), R16.1
unnamed: JP5.3 (B), R17.2
unnamed: JP6.2 (B), R18.1
unnamed: JP7.3 (B), R19.2
VDD: IC1.5, IC2.5; also elsewhere on the board
VDDA: R14.2, R16.2, R18.2; also elsewhere on the board
VR1-: IC1.1; also elsewhere on the board
VR2-: IC1.4; also elsewhere on the board
VR3-: IC2.1; also elsewhere on the board

Notes on the sheet:
Cam 1 and Crank Angle Sensors (G1 and NE)
Cam 2 Angle Sensor (G2)

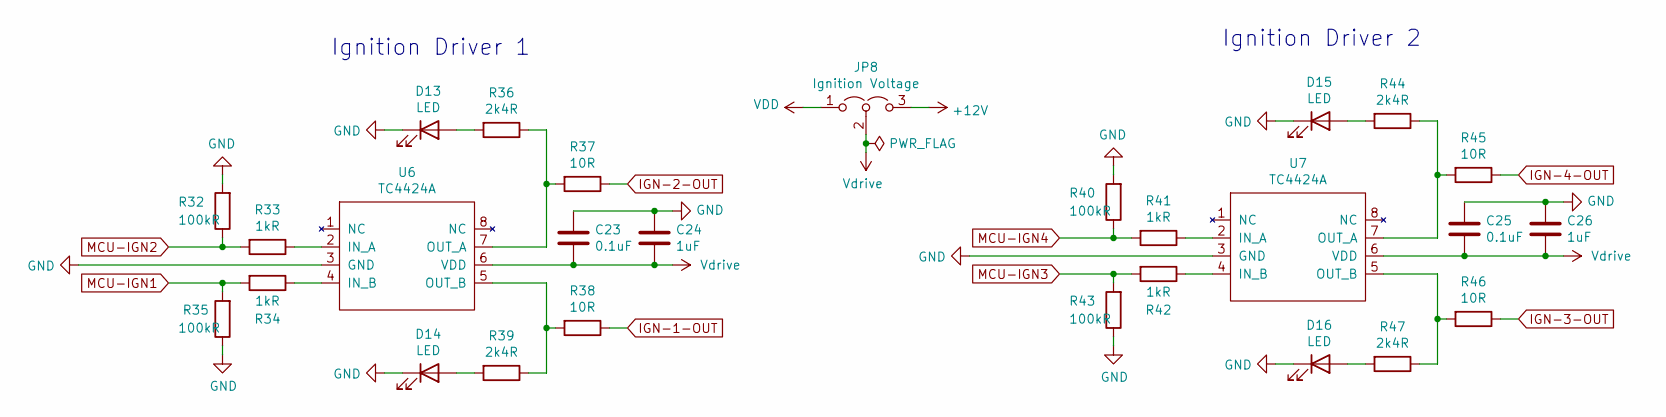
[picture p12: schematic Ignition.kicad_sch, Speeduino board for Teensy 4.1]

Parts:
C23, C25: 0.1uF; C_0805_2012Metric; Manufacturer_Part_Number VJ0805Y104KXAPW1BC; Digikey Part Number 3296136
C24, C26: 1uF; C_0805_2012Metric; Manufacturer_Part_Number CC0805KKX7R7BB105; Digikey Part Number 3369302
D13, D14, D15, D16: LED; LED_0805_2012Metric; Manufacturer_Part_Number MP008293; Digikey Part Number 3796325
JP8: Ignition Voltage; PinHeader_1x03_P2.54mm_Vertical
R32, R35, R40, R43: 100kR; R_0402_1005Metric; Manufacturer_Part_Number WF04P1003FTL; Digikey Part Number 2502803
R33, R34, R41, R42: 1kR; R_0402_1005Metric; Manufacturer_Part_Number WF04P1001FTL; Digikey Part Number 2502798
R36, R39, R44, R47: 2k4R; R_0805_2012Metric; Manufacturer_Part_Number MCWR08X2401FTL; Digikey Part Number 2447625
R37, R38, R45, R46: 10R; R_0402_1005Metric; Manufacturer_Part_Number WF04P10R0FTL; Digikey Part Number 2502794
U6, U7: TC4424A; SOIC-8_3.9x4.9mm_P1.27mm; Manufacturer_Part_Number TC4424AVOA; Digikey Part Number 738-6067

Connections:
+12V: JP8.3 (B); also elsewhere on the board
GND: C23.1, C24.1, C25.1, C26.1, D13.1 (K), D14.1 (K), D15.1 (K), D16.1 (K), R32.2, R35.1, R40.2, R43.1, U6.3 (GND), U7.3 (GND); also elsewhere on the board
IGN-1-OUT: R38.1; also elsewhere on the board
IGN-2-OUT: R37.1; also elsewhere on the board
IGN-3-OUT: R46.1; also elsewhere on the board
IGN-4-OUT: R45.1; also elsewhere on the board
MCU-IGN1: R34.2, R35.2; also elsewhere on the board
MCU-IGN2: R32.1, R33.2; also elsewhere on the board
MCU-IGN3: R42.2, R43.2; also elsewhere on the board
MCU-IGN4: R40.1, R41.2; also elsewhere on the board
unnamed: D13.2 (A), R36.2
unnamed: D14.2 (A), R39.2
unnamed: D15.2 (A), R44.2
unnamed: D16.2 (A), R47.2
unnamed: R33.1, U6.2 (IN_A)
unnamed: R34.1, U6.4 (IN_B)
unnamed: R36.1, R37.2, U6.7 (OUT_A)
unnamed: R38.2, R39.1, U6.5 (OUT_B)
unnamed: R41.1, U7.2 (IN_A)
unnamed: R42.1, U7.4 (IN_B)
unnamed: R44.1, R45.2, U7.7 (OUT_A)
unnamed: R46.2, R47.1, U7.5 (OUT_B)
VDD: JP8.1 (A); also elsewhere on the board
Vdrive: C23.2, C24.2, C25.2, C26.2, JP8.2 (C), U6.6 (VDD), U7.6 (VDD)

Notes on the sheet:
Ignition Driver 2
Ignition Driver 1

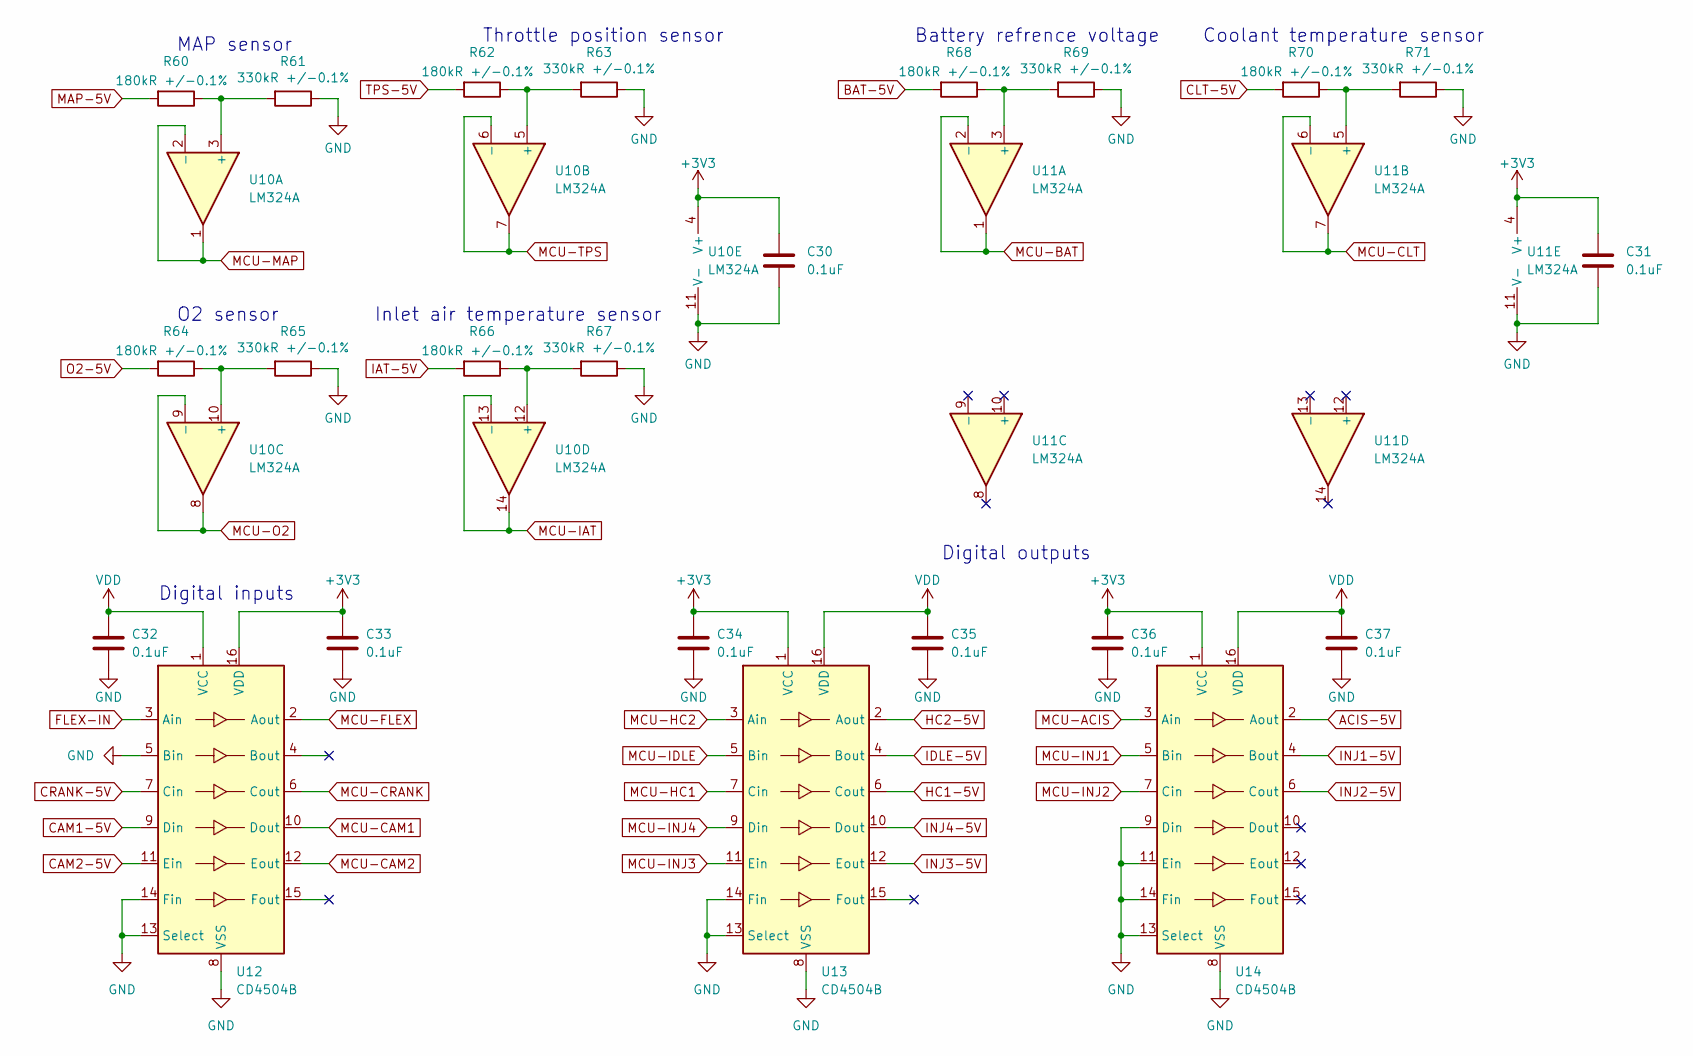
[picture p13: schematic Logic_convert.kicad_sch, Speeduino board for Teensy 4.1]

Parts:
C30, C31, C32, C33, C34, C35, C36, C37: 0.1uF; C_0805_2012Metric; Manufacturer_Part_Number VJ0805Y104KXAPW1BC; Digikey Part Number 3296136
R60, R62, R64, R66, R68, R70: 180kR +/-0.1%; R_0805_2012Metric; Manufacturer_Part_Number MCWF08R1803BTL; Digikey Part Number 2337663
R61, R63, R65, R67, R69, R71: 330kR +/-0.1%; R_0805_2012Metric; Manufacturer_Part_Number MCWF08R3303BTL; Digikey Part Number 2337789
U10, U11: LM324A; SOIC-14_3.9x8.7mm_P1.27mm; Manufacturer_Part_Number LM324ADR; Digikey Part Number 3117046
U12, U13, U14: CD4504B; TSSOP-16_4.4x5mm_P0.65mm; Manufacturer_Part_Number CD4504BPW; Digikey Part Number 3006769

Connections:
+3V3: C30.1, C31.1, C33.1, C34.1, C36.1, U10.4 (V+), U11.4 (V+), U12.16 (VDD), U13.1 (VCC), U14.1 (VCC); also elsewhere on the board
ACIS-5V: U14.2 (Aout); also elsewhere on the board
BAT-5V: R68.2; also elsewhere on the board
CAM1-5V: U12.9 (Din); also elsewhere on the board
CAM2-5V: U12.11 (Ein); also elsewhere on the board
CLT-5V: R70.2; also elsewhere on the board
CRANK-5V: U12.7 (Cin); also elsewhere on the board
FLEX-IN: U12.3 (Ain); also elsewhere on the board
GND: C30.2, C31.2, C32.2, C33.2, C34.2, C35.2, C36.2, C37.2, R61.1, R63.1, R65.1, R67.1, R69.1, R71.1, U10.11 (V-), U11.11 (V-), U12.5 (Bin), U12.8 (VSS), U12.13 (Select), U12.14 (Fin), U13.8 (VSS), U13.13 (Select), U13.14 (Fin), U14.8 (VSS), U14.9 (Din), U14.11 (Ein), U14.13 (Select), U14.14 (Fin); also elsewhere on the board
HC1-5V: U13.6 (Cout); also elsewhere on the board
HC2-5V: U13.2 (Aout); also elsewhere on the board
IAT-5V: R66.2; also elsewhere on the board
IDLE-5V: U13.4 (Bout); also elsewhere on the board
INJ1-5V: U14.4 (Bout); also elsewhere on the board
INJ2-5V: U14.6 (Cout); also elsewhere on the board
INJ3-5V: U13.12 (Eout); also elsewhere on the board
INJ4-5V: U13.10 (Dout); also elsewhere on the board
MAP-5V: R60.2; also elsewhere on the board
MCU-ACIS: U14.3 (Ain); also elsewhere on the board
MCU-BAT: U11.1, U11.2 (-); also elsewhere on the board
MCU-CAM1: U12.10 (Dout); also elsewhere on the board
MCU-CAM2: U12.12 (Eout); also elsewhere on the board
MCU-CLT: U11.6 (-), U11.7; also elsewhere on the board
MCU-CRANK: U12.6 (Cout); also elsewhere on the board
MCU-FLEX: U12.2 (Aout); also elsewhere on the board
MCU-HC1: U13.7 (Cin); also elsewhere on the board
MCU-HC2: U13.3 (Ain); also elsewhere on the board
MCU-IAT: U10.13 (-), U10.14; also elsewhere on the board
MCU-IDLE: U13.5 (Bin); also elsewhere on the board
MCU-INJ1: U14.5 (Bin); also elsewhere on the board
MCU-INJ2: U14.7 (Cin); also elsewhere on the board
MCU-INJ3: U13.11 (Ein); also elsewhere on the board
MCU-INJ4: U13.9 (Din); also elsewhere on the board
MCU-MAP: U10.1, U10.2 (-); also elsewhere on the board
MCU-O2: U10.8, U10.9 (-); also elsewhere on the board
MCU-TPS: U10.6 (-), U10.7; also elsewhere on the board
unnamed: R60.1, R61.2, U10.3 (+)
unnamed: R62.1, R63.2, U10.5 (+)
unnamed: R64.1, R65.2, U10.10 (+)
unnamed: R66.1, R67.2, U10.12 (+)
unnamed: R68.1, R69.2, U11.3 (+)
unnamed: R70.1, R71.2, U11.5 (+)
O2-5V: R64.2; also elsewhere on the board
TPS-5V: R62.2; also elsewhere on the board
VDD: C32.1, C35.1, C37.1, U12.1 (VCC), U13.16 (VDD), U14.16 (VDD); also elsewhere on the board

Notes on the sheet:
Digital outputs
Digital inputs
Inlet air temperature sensor
MAP sensor
Battery refrence voltage
Coolant temperature sensor
Throttle position sensor
O2 sensor

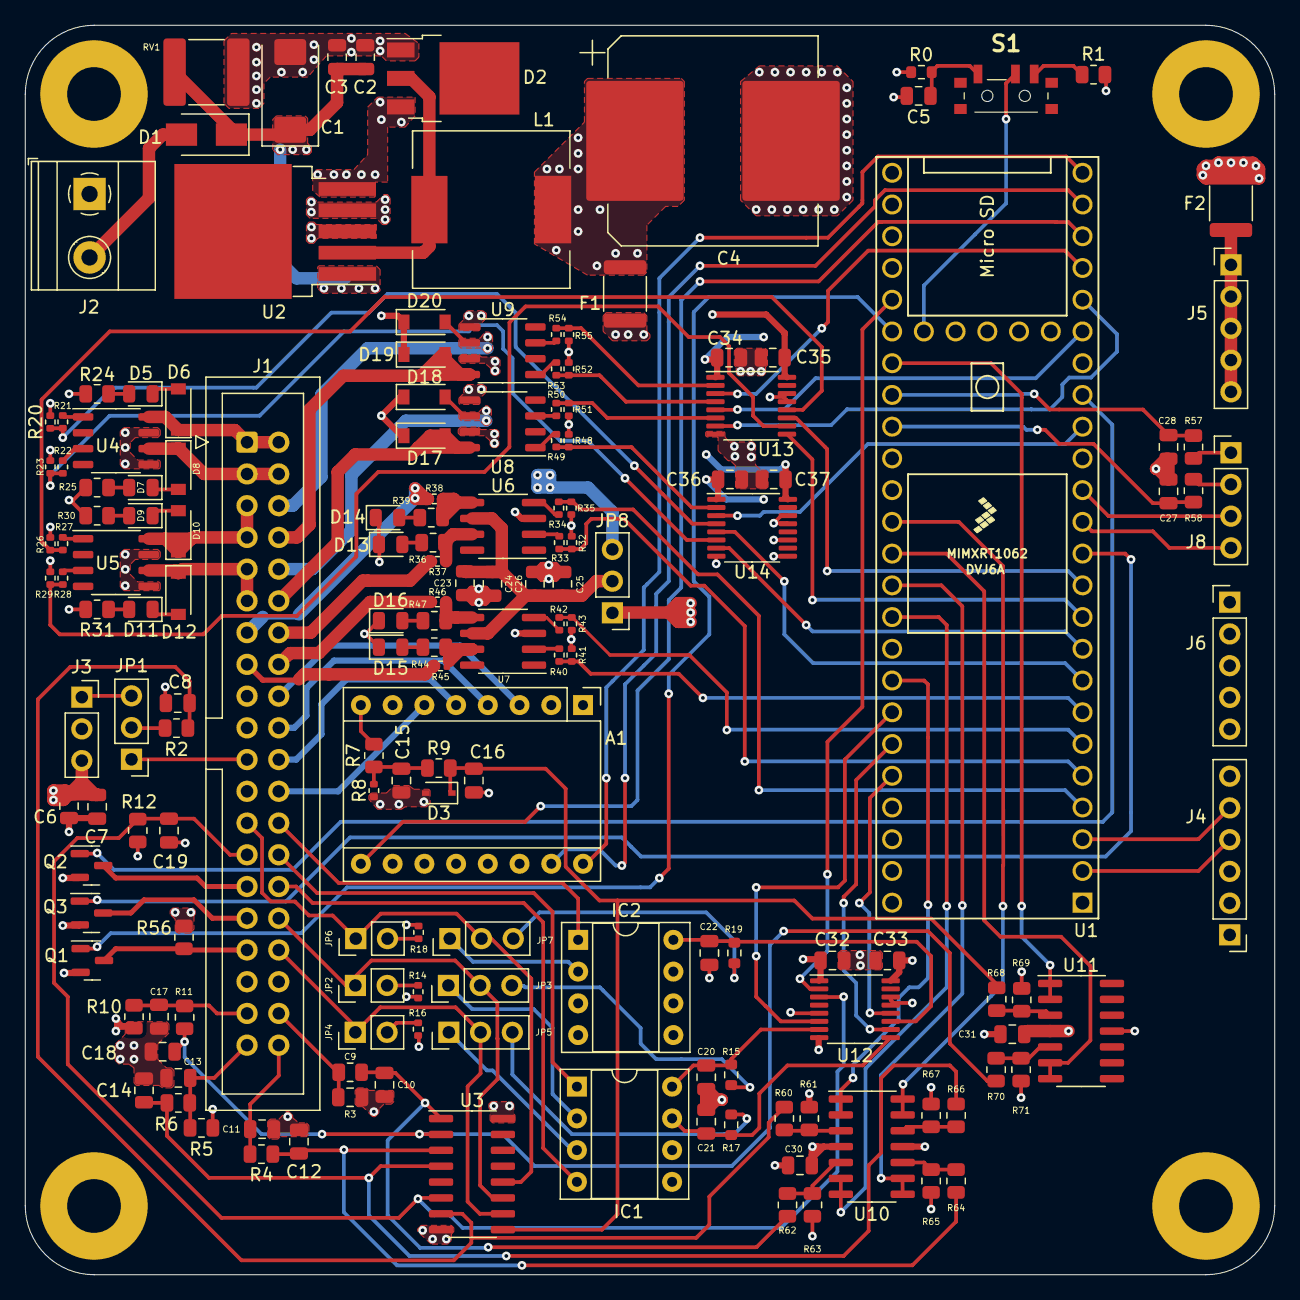
[picture p14: board perfectV2.1v0.kicad_pcb from above]

Board: 4 copper layers, 100.0 x 100.0 mm, 169 parts (0 on the bottom side), 142 nets.
