fer-clerkx/speeduino-expo/(commit log)

2023-01-04 Removed previous PCB layout, updated title blocks, changed stackup
    [Crank_and_cam.kicad_sch, Fuel.kicad_sch, Ignition.kicad_sch, Logic_convert.kicad_sch, connector.kicad_sch, inputs.kicad_sch, outputs.kicad_sch, perfectV2.1v0.kicad_pcb]
2023-01-04 Assigned fp to mounting holes, removed datasheet fields
    [Fuel.kicad_sch, Ignition.kicad_sch, Logic_convert.kicad_sch, inputs.kicad_sch, outputs.kicad_sch, perfectV2.1v0.kicad_sch, power.kicad_sch]
2023-01-04 Swapped which angle sensors are connected to VR conditioners
    [Crank_and_cam.kicad_sch, connector.kicad_sch, inputs.kicad_sch, perfectV2.1v0.kicad_sch]
2023-01-06 Completed layout, slight changes to schematic to optimise routing, 12V proto supply rail removed
    [Fuel.kicad_sch, Logic_convert.kicad_sch, inputs.kicad_sch, outputs.kicad_sch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]
2023-01-06 Added adapter board
    [Crank_and_cam.kicad_sch, Fuel.kicad_sch, Ignition.kicad_sch, Logic_convert.kicad_sch, Speeduino 1990 Rev2 3SGE ECU adapter 174518-7.kicad_pcb, Speeduino 1990 Rev2 3SGE ECU adapter 174518-7.kicad_sch, connector.kicad_sch, inputs.kicad_sch]
2023-01-07 Removed clutch input
    [Crank_and_cam.kicad_sch, Fuel.kicad_sch, Ignition.kicad_sch, Logic_convert.kicad_sch, connector.kicad_sch, inputs.kicad_sch, outputs.kicad_sch, perfectV2.1v0.kicad_pcb]
2023-01-07 Updated gerber files
    [perfectV2.1v0-B_Cu.gbl, perfectV2.1v0-B_Mask.gbs, perfectV2.1v0-B_Paste.gbp, perfectV2.1v0-B_Silkscreen.gbo, perfectV2.1v0-Edge_Cuts.gm1, perfectV2.1v0-F_Cu.gtl, perfectV2.1v0-F_Mask.gts, perfectV2.1v0-F_Paste.gtp]
2023-01-07 Changed Boost output to ACIS
    [Logic_convert.kicad_sch, connector.kicad_sch, outputs.kicad_sch, perfectV2.1v0.kicad_pcb, perfectV2.1v0.kicad_sch]
2023-01-07 Finished adapter board, slight changes to ECU
    [Speeduino 1990 Rev2 3SGE ECU adapter 174518-7-B_Cu.gbl, Speeduino 1990 Rev2 3SGE ECU adapter 174518-7-B_Mask.gbs, Speeduino 1990 Rev2 3SGE ECU adapter 174518-7-B_Paste.gbp, Speeduino 1990 Rev2 3SGE ECU adapter 174518-7-B_Silkscreen.gbo, Speeduino 1990 Rev2 3SGE ECU adapter 174518-7-Edge_Cuts.gm1, Speeduino 1990 Rev2 3SGE ECU adapter 174518-7-F_Cu.gtl, Speeduino 1990 Rev2 3SGE ECU adapter 174518-7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]
2023-01-08 Added dril files
    [Speeduino 1990 Rev2 3SGE ECU adapter 174518-7-NPTH.drl, Speeduino 1990 Rev2 3SGE ECU adapter 174518-7-PTH.drl, perfectV2.1v0-NPTH.drl, perfectV2.1v0-PTH.drl]
2023-01-09 Fixed silkscreen mirroring
    [Speeduino 1990 Rev2 3SGE ECU adapter 174518-7-B_Cu.gbl, Speeduino 1990 Rev2 3SGE ECU adapter 174518-7-B_Mask.gbs, Speeduino 1990 Rev2 3SGE ECU adapter 174518-7-B_Paste.gbp, Speeduino 1990 Rev2 3SGE ECU adapter 174518-7-B_Silkscreen.gbo, Speeduino 1990 Rev2 3SGE ECU adapter 174518-7-Edge_Cuts.gm1, Speeduino 1990 Rev2 3SGE ECU adapter 174518-7-F_Cu.gtl, Speeduino 1990 Rev2 3SGE ECU adapter 174518-7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]
